schandreas/WordClock/README.md

# WordClock
WordClock based on a cheap stm32 chip (STM32F030RCT6TR)
