schandreas/WordClock/v01partnumbers__farnell.xlsx

Nr. | Best.-Nr. | RoHS-konform? | Ihre Bestellnummer | Hinweise | Menge | Hersteller-Teilenr. | Herstellername | Hersteller / Beschreibung | Verfügbarkeit | Stückpreis | Positionspreis | Rabattpreis
1 | 2488282 | YES |  |  | 1.0 | STM32F030RCT6 | STMICROELECTRONICS | STMICROELECTRONICS ARM-Mikrocontroller, Value Line, STM32 Family STM32F0 Series Microcontrollers, ARM Cortex-M0, 32bit | 4788 | 2.8000 | 2.80
2 | 1842268 | YES |  |  | 1.0 | 9B-8.000MAAJ-B | TXC | TXC Quarz, 8 MHz, Durchsteckmontage, 11.5mm x 5mm, 30 ppm, 18 pF, 30 ppm, Baureihe 9B | 3753 | 0.4230 | 0.42
3 | 2896334 | YES |  |  | 10.0 | VJ0402A180JXJPW1BC | VISHAY | VISHAY Keramikvielschichtkondensator, SMD, 18 pF, 16 V, 0402 [Metrisch 1005], ± 5%, C0G / NP0, VJ Series | 48580 | 0.0130 | 0.13
4 | 2896366 | YES |  |  | 10.0 | VJ0603A120JXACW1BC | VISHAY | VISHAY Keramikvielschichtkondensator, SMD, 12 pF, 50 V, 0603 [Metrisch 1608], ± 5%, C0G / NP0, VJ Series | 1900 | 0.0129 | 0.13
5 | 1611828 | YES |  |  | 1.0 | AB38T-32.768KHZ | ABRACON | ABRACON Quarz, 32.768 kHz, Zylinder, radial bedrahtet, 8.2mm x 3.2mm Durchm., 12.5 pF, 20 ppm | 36976 | 0.1670 | 0.17
6 | 2861962 | YES |  |  | 10.0 | CRGCQ1206J100K | TE CONNECTIVITY | TE CONNECTIVITY Chipwiderstand, Oberflächenmontage, 100 kohm, CRGCQ Series, 200 V, Dickschicht | 2250 | 0.0139 | 0.14
7 | 1100192 | YES |  |  | 20.0 | WCR1206-1K0FI | TT ELECTRONICS / WELWYN | TT ELECTRONICS / WELWYN Dickschicht-Chipwiderstand, SMD, Baureihe WCR, AEC-Q200, 1K, 200V, 1206 [Metrisch 3216], 250mW, ± 1% | 46594 | 0.0204 | 0.41
8 | 1653608 | YES |  |  | 5.0 | BC857BDW1T1G | ON SEMICONDUCTOR | ON SEMICONDUCTOR Bipolares Transistor-Array, Universal, PNP, -45 V, 380 mW, 100 mA, 150 hFE, SOT-363 | 58 | 0.1450 | 0.73
9 | 1694439 | YES |  |  | 1.0 | TLC5925IPWR | TEXAS INSTRUMENTS | TEXAS INSTRUMENTS LED-Treiber, 16 Ausgänge, Konstantstrom, 3V-5.5Vin, 30MHz Schaltfrequenz, 20V/45mAout, TSSOP-24 | 3296 | 1.2000 | 1.20
10 | 2896535 | YES |  |  | 10.0 | VJ0805V105MXXRW1BC | VISHAY | VISHAY Keramikvielschichtkondensator, SMD, 1 µF, 25 V, 0805 [Metrisch 2012], ± 20%, Y5V, VJ Series | 6420 | 0.0528 | 0.53
11 | 2428194 | YES |  |  | 5.0 | SRN2510-R68M | BOURNS | BOURNS Leistungsinduktivität (SMD), 680 nH, 2.8 A, Halbgeschirmt, 2.9 A, Baureihe SRN2510 | 1965 | 0.1400 | 0.70
12 | 2466241 | YES |  |  | 1.0 | 865080140001 | WURTH ELEKTRONIK | WURTH ELEKTRONIK Aluminium-Elektrolytkondensatoren, SMD, Becher, radial - SMD, 22 µF, 6.3 V, Baureihe WCAP-ASLI | Out of Stock | 0.1750 | 0.18
13 | 1100222 | YES |  |  | 10.0 | WCR1206-13KFI | TT ELECTRONICS / WELWYN | TT ELECTRONICS / WELWYN Dickschicht-Chipwiderstand, SMD, Baureihe WCR, AEC-Q200, 13K, 200V, 1206 [Metrisch 3216], 250mW | 21741 | 0.0150 | 0.15
14 | 2307687 | YES |  |  | 10.0 | ERJ8ENF4022V | PANASONIC ELECTRONIC COMPONENTS | PANASONIC ELECTRONIC COMPONENTS Chipwiderstand, Oberflächenmontage, Dickschicht, 40.2 kohm, Baureihe ERJ8E, 200 V, Dickschicht | 6149 | 0.0667 | 0.67
15 | 2307784 | YES |  |  | 10.0 | ERJ8ENF5902V | PANASONIC ELECTRONIC COMPONENTS | PANASONIC ELECTRONIC COMPONENTS Chipwiderstand, Oberflächenmontage, Dickschicht, 59 kohm, Baureihe ERJ8E, 200 V, Dickschicht | 2266 | 0.0629 | 0.63
16 | MISSING | - |  |  | - | AP65111AWU-7 | -> RS.: 146-4830 | IC REG BUCK ADJ 1.5A SYNC
 |  |  |  |  |  |  | Zwischensumme | 8.97
 |  |  |  |  |  |  | Warengesamtsumme | 8.97
 |  |  |  |  |  |  | Lieferung | 0.00
 |  |  |  |  |  |  | Versandkosten | 5.95
 |  |  |  |  |  |  | USt. | 1.19
 |  |  |  |  |  |  | Gesamt | 16.11
