schandreas/WordClock/v01partnumbers__digikey.xlsx

Index | Menge | Teilenummer | Hersteller-Teilenummer | Beschreibung | Kundenreferenz | Verfügbar | Lieferrückstände | Stückpreis | Gesamtpreis EUR
1 | 1 | 497-17337-1-ND | STM32F030RCT6TR | IC MCU 32BIT 256KB FLASH 64LQFP |  | 1 | 0 | 250000 | 250
2 | 1 | 535-9062-ND | ABL-8.000MHZ-B2 | CRYSTAL 8.0000MHZ 18PF T/H |  | 1 | 0 | 28000 | 28
3 | 2 | 490-5858-1-ND | GRM1555C1H180JA01D | CAP CER 18PF 50V C0G/NP0 0402 |  | 2 | 0 | 9000 | 18
4 | 2 | 1276-1178-1-ND | CL05C120JB5NNNC | CAP CER 12PF 50V C0G/NP0 0402 |  | 2 | 0 | 9000 | 18
5 | 1 | 535-9034-ND | AB38T-32.768KHZ | CRYSTAL 32.7680KHZ 12.5PF T/H |  | 1 | 0 | 15000 | 15
6 | 2 | P100KFCT-ND | ERJ-8ENF1003V | RES SMD 100K OHM 1% 1/4W 1206 |  | 2 | 0 | 9000 | 18
7 | 11 | P1.0KECT-ND | ERJ-8GEYJ102V | RES SMD 1K OHM 5% 1/4W 1206 |  | 11 | 0 | 6300 | 69
8 | 5 | MBT3906DW1T1GOSCT-ND | MBT3906DW1T1G | TRANS 2PNP 40V 0.2A SC88 |  | 5 | 0 | 18000 | 90
9 | 1 | 296-24466-1-ND | TLC5925IPWR | IC LED DRIVER LIN 45MA 24TSSOP |  | 1 | 0 | 128000 | 128
10 | 1 | AP65111AWU-7DICT-ND | AP65111AWU-7 | IC REG BUCK ADJ 1.5A SYNC |  | 1 | 0 | 38000 | 38
11 | 1 | 1276-6471-1-ND | CL21B105KOFNNNG | CAP CER 1UF 16V X7R 0805 |  | 1 | 0 | 9000 | 9
12 | 1 | 587-2391-1-ND | NRH2410T6R8MN | FIXED IND 6.8UH 570MA 492 MOHM |  | 1 | 0 | 20000 | 20
13 | 1 | 311-40.2KFRCT-ND | RC1206FR-0740K2L | RES SMD 40.2K OHM 1% 1/4W 1206 |  | 1 | 0 | 9000 | 9
14 | 1 | 311-59.0KFRCT-ND | RC1206FR-0759KL | RES SMD 59K OHM 1% 1/4W 1206 |  | 1 | 0 | 9000 | 9
15 | 1 | 311-13.0KFRCT-ND | RC1206FR-0713KL | RES SMD 13K OHM 1% 1/4W 1206 |  | 1 | 0 | 9000 | 9
16 | 1 | 732-8466-1-ND | 865080140001 | CAP 22 UF 20% 6.3 V |  | 1 | 0 | 15000 | 15
