schandreas/WordClock/WordClock_eagle/wordclockv0.1.brd

## EAGLE design WordClock_eagle/wordclockv0.1.brd (2018-11-28)

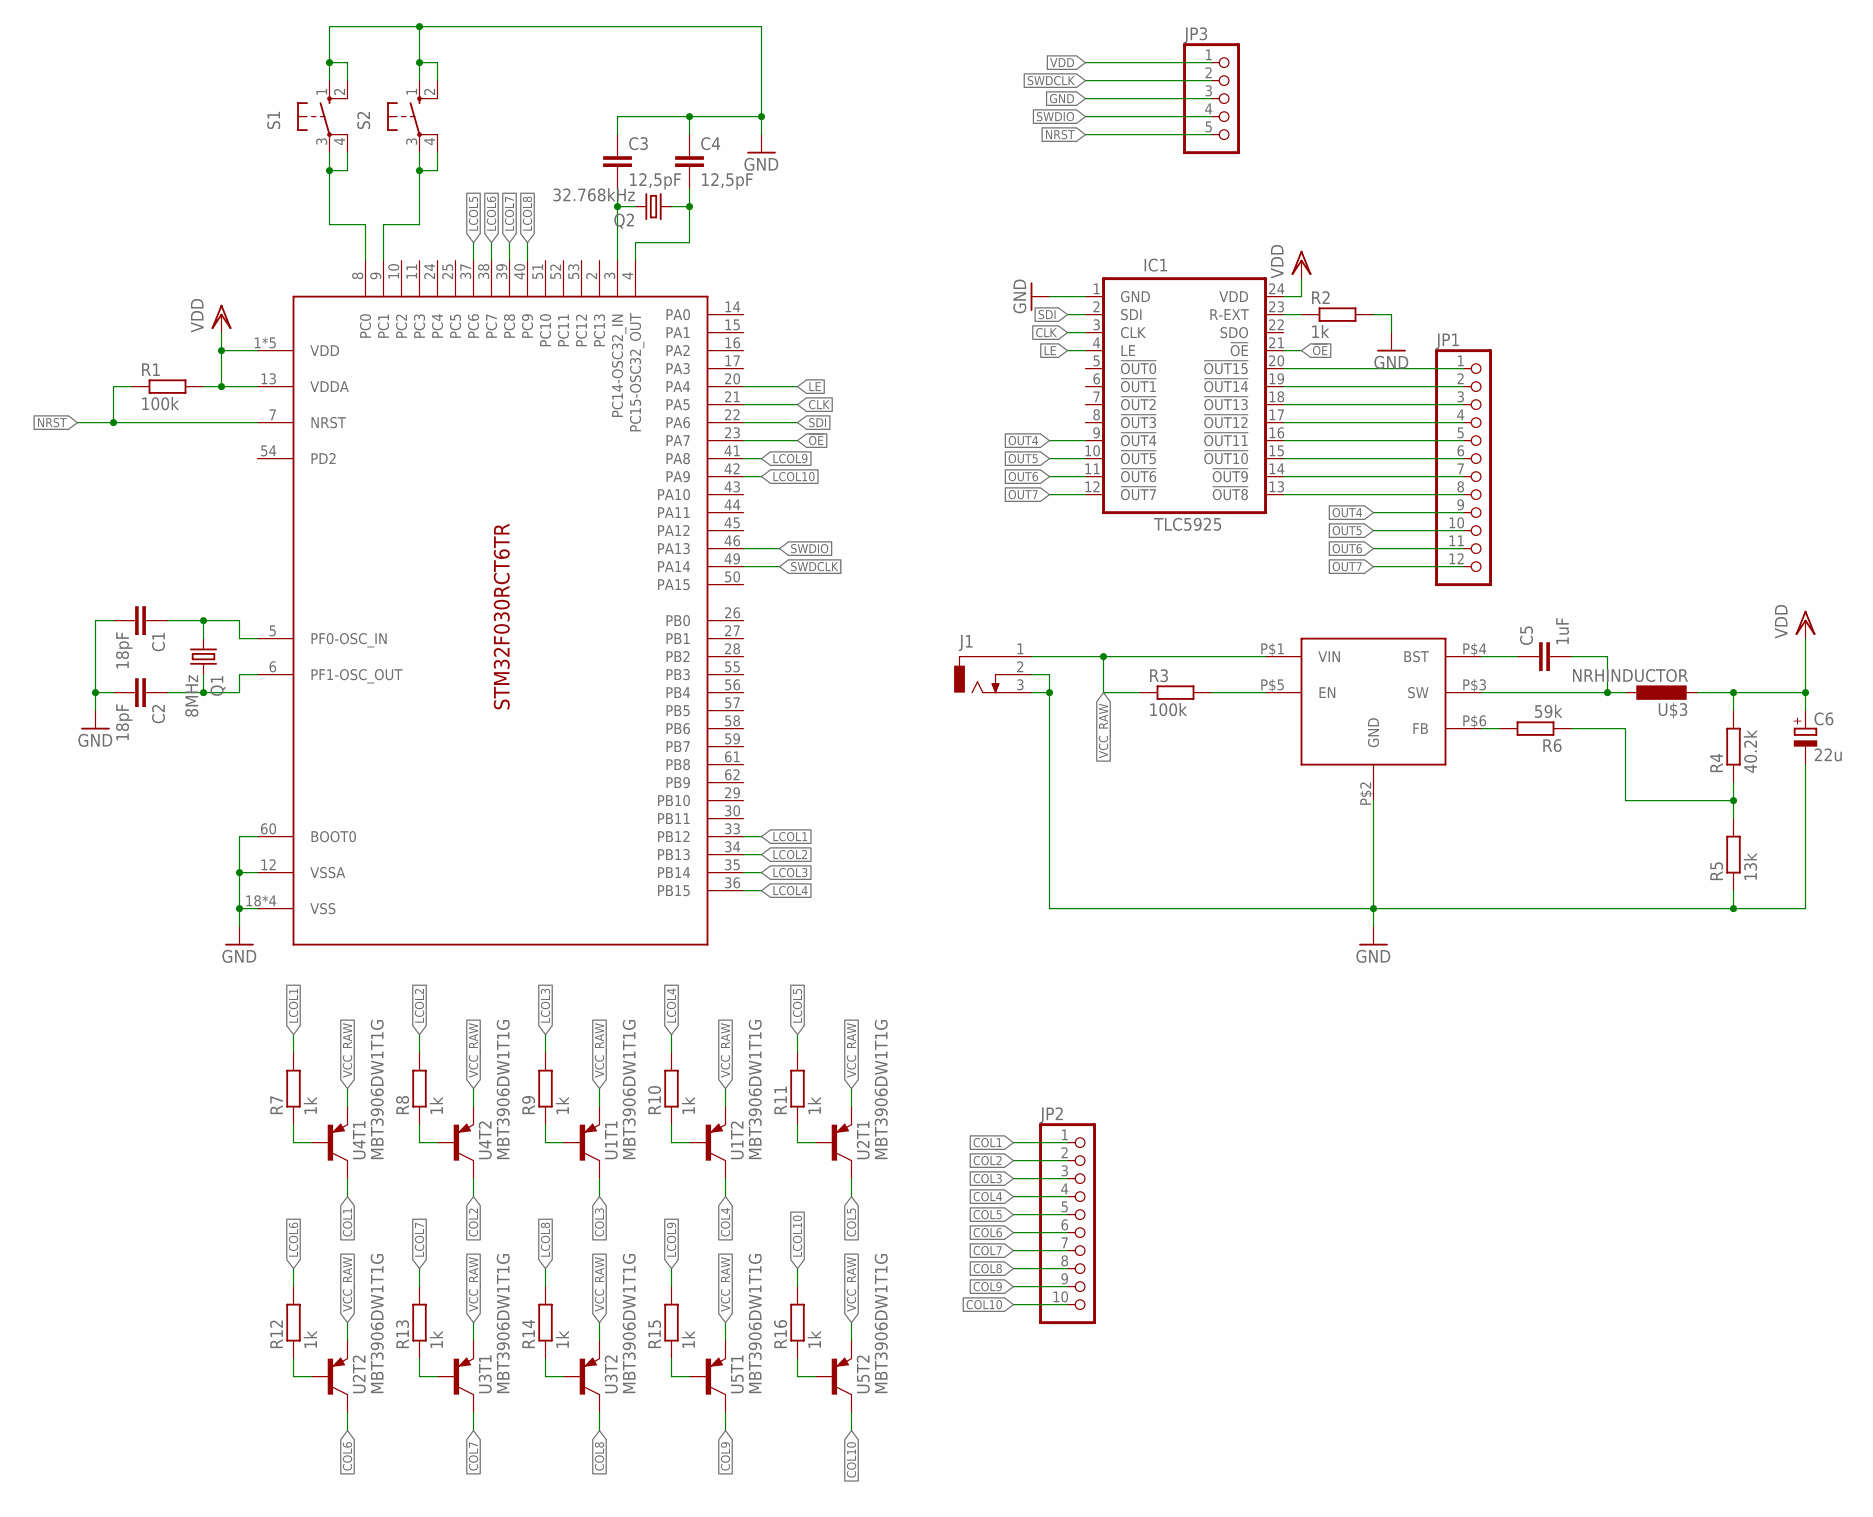
[picture p1: schematic wordclockv0.1.sch]

Parts:
C1, C2: 18pF; C0402
C3, C4: 12,5pF; C0402
C5: 1uF; C0805
C6: 22u; 153CLV-0405
IC1: TLC5925; SO24W
J1: DCJ0303
JP1: PINHD-1X12; 1X12
JP2: PINHD-1X10; 1X10
JP3: PINHD-1X5; 1X05
Q1: 8MHz; HC49U-V
Q2: 32.768kHz; TC26V
R1, R3: 100k; M1206
R2, R7, R8, R9, R10, R11, R12, R13, R14, R15, R16: 1k; M1206
R4: 40.2k; M1206
R5: 13k; M1206
R6: 59k; M1206
S1, S2: 10-XX; B3F-10XX
U1, U2, U3, U4, U5: MBT3906DW1T1G; SOT363-INFINION
U$1: STM32F030RCT6TRLQFP64; LQFP64
U$2: AP65111A; TSOT26
U$3: NRHINDUCTOR

Connections:
!OE: IC1.21 (!OE), U$1.23 (PA7)
CLK: IC1.3 (CLK), U$1.21 (PA5)
COL1: JP2.1, U4.6 (C)
COL2: JP2.2, U4.3 (C)
COL3: JP2.3, U1.6 (C)
COL4: JP2.4, U1.3 (C)
COL5: JP2.5, U2.6 (C)
COL6: JP2.6, U2.3 (C)
COL7: JP2.7, U3.6 (C)
COL8: JP2.8, U3.3 (C)
COL9: JP2.9, U5.6 (C)
COL10: JP2.10, U5.3 (C)
GND: C1.2, C2.2, C3.1, C4.1, C6.-, IC1.1 (GND), J1.2, J1.3, JP3.3, R2.2, R5.1, S1.1 (S), S1.2 (S1), S2.1 (S), S2.2 (S1), U$1.12 (VSSA), U$1.18 (VSS), U$1.31 (VSS), U$1.47 (VSS), U$1.60 (BOOT0), U$1.63 (VSS), U$2.P$2 (GND)
LCOL1: R7.2, U$1.33 (PB12)
LCOL2: R8.2, U$1.34 (PB13)
LCOL3: R9.2, U$1.35 (PB14)
LCOL4: R10.2, U$1.36 (PB15)
LCOL5: R11.2, U$1.37 (PC6)
LCOL6: R12.2, U$1.38 (PC7)
LCOL7: R13.2, U$1.39 (PC8)
LCOL8: R14.2, U$1.40 (PC9)
LCOL9: R15.2, U$1.41 (PA8)
LCOL10: R16.2, U$1.42 (PA9)
LE: IC1.4 (LE), U$1.20 (PA4)
unnamed: C1.1, Q1.1, U$1.5 (PF0-OSC_IN)
unnamed: C2.1, Q1.2, U$1.6 (PF1-OSC_OUT)
unnamed: C4.2, Q2.1, U$1.4 (PC15-OSC32_OUT)
unnamed: C3.2, Q2.2, U$1.3 (PC14-OSC32_IN)
unnamed: C5.1, U$2.P$4 (BST)
unnamed: R3.2, U$2.P$5 (EN)
unnamed: IC1.23 (R-EXT), R2.1
unnamed: C5.2, U$2.P$3 (SW), U$3.P$1 (1)
unnamed: R6.2, U$2.P$6 (FB)
unnamed: R4.1, R5.2, R6.1
unnamed: R7.1, U4.2 (B)
unnamed: R8.1, U4.5 (B)
unnamed: S1.3, S1.4 (P1), U$1.8 (PC0)
unnamed: R9.1, U1.2 (B)
unnamed: R10.1, U1.5 (B)
unnamed: S2.3, S2.4 (P1), U$1.9 (PC1)
unnamed: R11.1, U2.2 (B)
unnamed: R12.1, U2.5 (B)
unnamed: IC1.20 (!OUT15), JP1.1
unnamed: IC1.19 (!OUT14), JP1.2
unnamed: IC1.18 (!OUT13), JP1.3
unnamed: IC1.17 (!OUT12), JP1.4
unnamed: IC1.16 (!OUT11), JP1.5
unnamed: IC1.15 (!OUT10), JP1.6
unnamed: IC1.14 (!OUT9), JP1.7
unnamed: IC1.13 (!OUT8), JP1.8
unnamed: R13.1, U3.2 (B)
unnamed: R14.1, U3.5 (B)
unnamed: R15.1, U5.2 (B)
unnamed: R16.1, U5.5 (B)
NRST: JP3.5, R1.1, U$1.7 (NRST)
OUT4: IC1.9 (!OUT4), JP1.9
OUT5: IC1.10 (!OUT5), JP1.10
OUT6: IC1.11 (!OUT6), JP1.11
OUT7: IC1.12 (!OUT7), JP1.12
SDI: IC1.2 (SDI), U$1.22 (PA6)
SWDCLK: JP3.2, U$1.49 (PA14)
SWDIO: JP3.4, U$1.46 (PA13)
VCC_RAW: J1.1, R3.1, U1.1 (E), U1.4 (E), U2.1 (E), U2.4 (E), U3.1 (E), U3.4 (E), U4.1 (E), U4.4 (E), U5.1 (E), U5.4 (E), U$2.P$1 (VIN)
VDD: C6.+, IC1.24 (VDD), JP3.1, R1.2, R4.2, U$1.1 (VDD), U$1.13 (VDDA), U$1.19 (VDD), U$1.32 (VDD), U$1.48 (VDD), U$1.64 (VDD), U$3.P$2 (2)

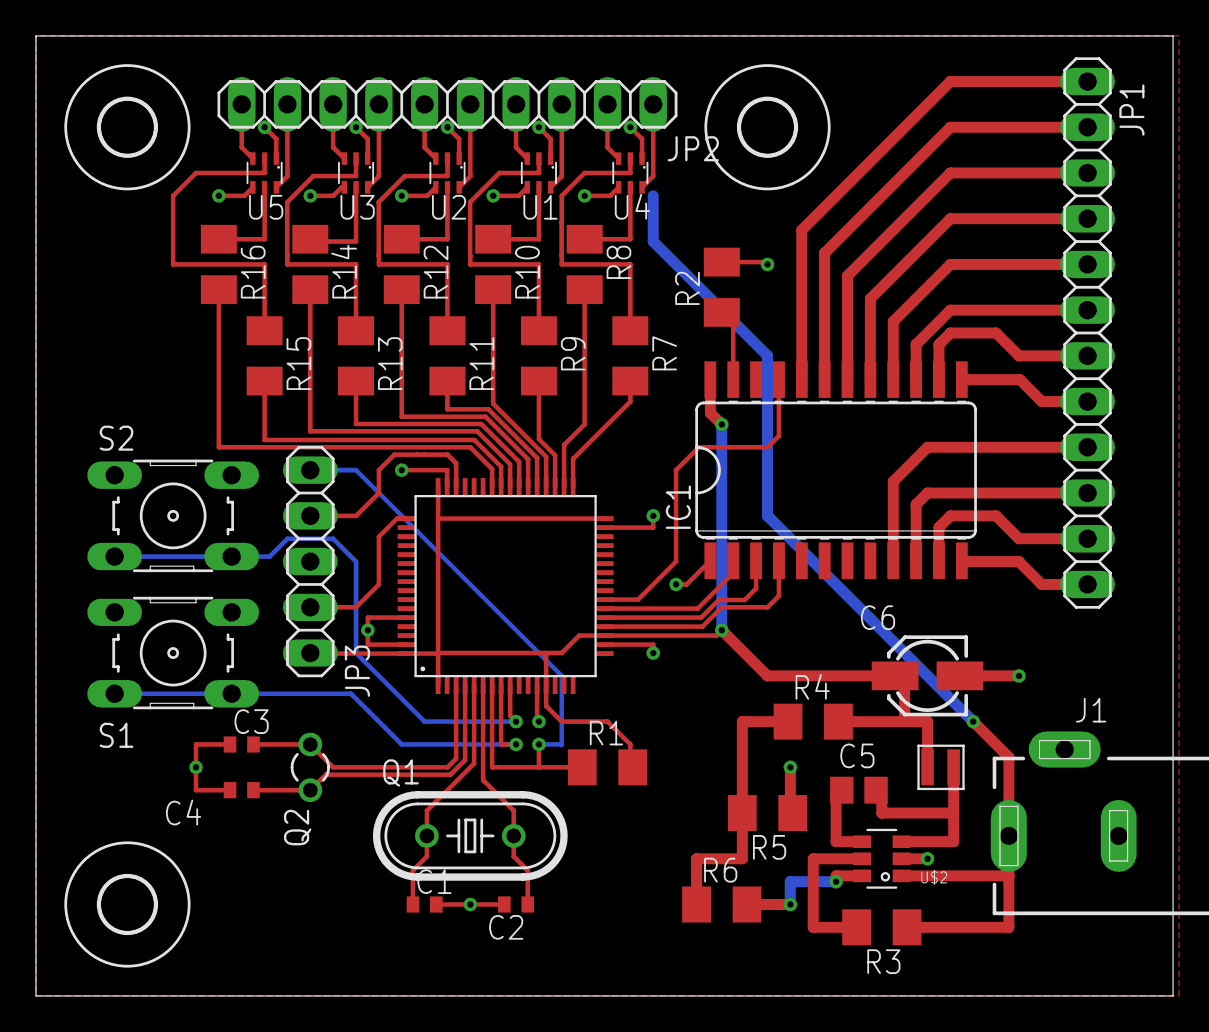
[picture p2: board wordclockv0.1.brd from above]

Board: 2 copper layers, 63.2 x 53.3 mm, 42 parts (0 on the bottom side), 64 nets.

Other parts of the board:
U$4, U$5, U$6: 3,0
