schandreas/WordClock/src_code/HAL_Implementation/HAL_Implementation.ioc

Mcu.UserName=STM32F030RCTx
PA13.Signal=SYS_SWDIO
PA14.Signal=SYS_SWCLK
PA4.GPIO_Label=LE
PA4.Signal=GPIO_Output
PA5.GPIO_Label=CLK
PA5.Signal=GPIO_Output
PA6.GPIO_Label=SDI
PA6.Signal=GPIO_Output
PA7.GPIO_Label=OE
PA7.Signal=GPIO_Output
PA8.GPIO_Label=LCOL9
PA8.Signal=GPIO_Output
PA9.GPIO_Label=LCOL10
PA9.Signal=GPIO_Output
PB12.GPIO_Label=LCOL1
PB12.Signal=GPIO_Output
PB13.GPIO_Label=LCOL2
PB13.Signal=GPIO_Output
PB14.GPIO_Label=LCOL3
PB14.Signal=GPIO_Output
PB15.GPIO_Label=LCOL4
PB15.Signal=GPIO_Output
PC0.GPIO_Label=BTN1
PC0.Signal=GPIO_Input
PC1.GPIO_Label=BTN2
PC1.Signal=GPIO_Input
PC14OSC32_IN.Signal=RCC_OSC32_IN
PC15OSC32_OUT.Signal=RCC_OSC32_OUT
PC6.GPIO_Label=LCOL5
PC6.Signal=GPIO_Output
PC7.GPIO_Label=LCOL6
PC7.Signal=GPIO_Output
PC8.GPIO_Label=LCOL7
PC8.Signal=GPIO_Output
PC9.GPIO_Label=LCOL8
PC9.Signal=GPIO_Output
PF0-OSC_IN.Signal=RCC_OSC_IN
PF1-OSC_OUT.Signal=RCC_OSC_OUT
