schandreas/WordClock/(commit log)

2018-09-26 Added everything there is so far
    [wordclockv0.1.sch]
2018-09-26 Corrected spelling error. Worked on schematic.
    Spelling was bugging me. Had to get this out:disappointed_relieved:
    [wordclockv0.1.sch]
2018-09-26 Changed the crystal
    [wordclockv0.1.sch]
2018-09-27 Started the board. Still a lot of problems. not finished
    [wordclockv0.1.brd, wordclockv0.1.sch]
2018-09-27 schematic changes. deleted brd
    board was deleted because i added a switching regulator and i'd need to rework the whole thing anyway. no point in keeping it. :imp:
    [wordclockv0.1.brd, wordclockv0.1.sch]
2018-09-27 schematic changes. deleted brd. lbr changes
    I also added devices for the regulator and the inductor i need to the lbr.
    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
    [wordclockv0.1.brd, wordclockv0.1.sch]
2018-09-27 Finished schematic for now. Starting on board
    [wordclockv0.1.brd, wordclockv0.1.sch]
2018-09-28 Did the board. Rough draft without consideration for manufacturing
    Fabricating this thing is going to be hell :imp:
    [wordclockv0.1.brd, wordclockv0.1.sch]
2018-09-28 Added cam file for manufacturing
    noone screamed at me yet
    [wordclockv0.1.brd]
2018-09-28 Made a parts list from digikey. Changed some components bc cheaper
    Whoa this was a piece of work.
    [v01partnumbers__digikey.xlsx, wordclockv0.1.brd, wordclockv0.1.sch]
2018-10-03 Small changes to schematic and pcb
    [wordclockv0.1.brd, wordclockv0.1.sch]
2018-10-03 Removed wire stubs from board. Also added .cam file for generating jlcpcb
    [wordclockv0.1.brd]
2018-10-17 Leds are now fed by VCC_RAW instead of 3V3
    [wordclockv0.1.brd, wordclockv0.1.sch]
2018-10-24 Updated the cam file for jlcpcb. The other files are just minor changes
    idk bro seems pretty sketchy
    [v01partnumbers__digikey.xlsx, wordclockv0.1.brd, wordclockv0.1.sch]
2018-10-27 Added config for STM32CubeMX. This starts the software side of things
    Dear god help me i am such an idiot at programming these things. If you think you can improve upon my shitty excuse for code you are welcome to submit a pull request. Every little thing helps
2018-10-29 Removed redundant .ioc file. Added Part numbers for farnell
    [v01partnumbers__farnell.xlsx]
2018-11-07 Added CAD File for German Front panel.
    Made by Sandra D.
    She didn't want to give me her twitter. go shout at her instead
    [v01partnumbers__farnell.xlsx]
2018-11-16 Did some groundwork on the code.
    Scream at me all you want the code is staying this bad.
2018-11-17 Finished the first version that hopefully (?) works
    Honestly this thing is probably filled to the brim with bugs but I don't have the hardware yet. Monday should be the frist day of actual testing
    [HAL_Implementation.ioc, main.c]
2018-11-28 Fixing huge error with stm32 pinout. Also revising board
    My package was numbered differently than the diagram in the datasheet. Didn't realize until the thing was hot to the touch and not responding. sucks to be me
    [wordclockv0.1.brd, wordclockv0.1.sch]
